dgatf/msrc_arduino/msrc_gui/res/acs758_micro.png

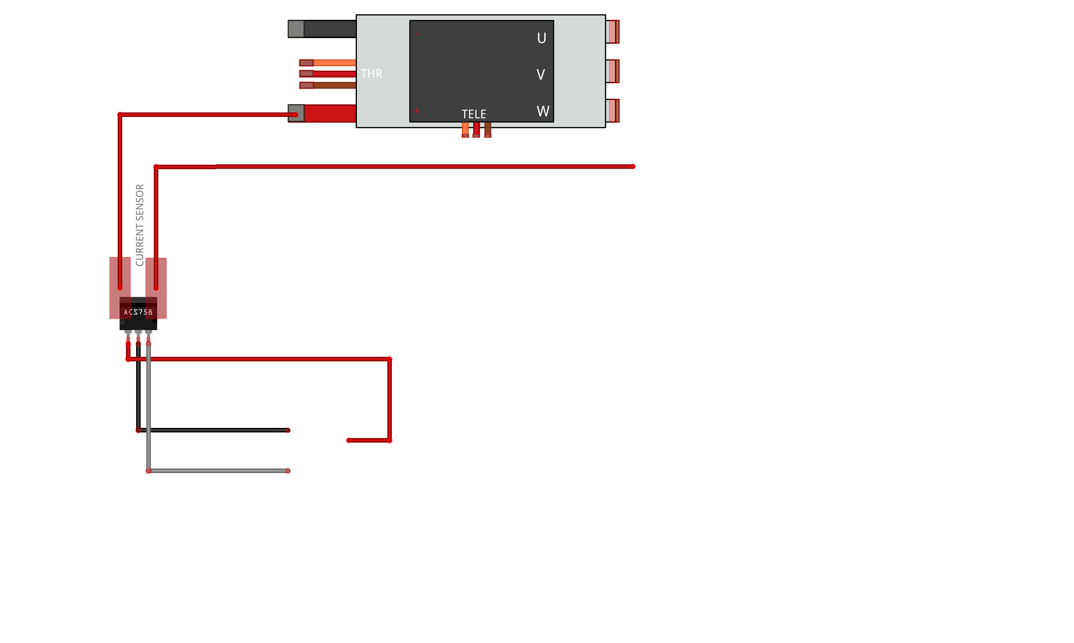
msrc_gui/res/acs758_micro.png
