dgatf/msrc_arduino/msrc_gui/res/acs758_pro_micro.png

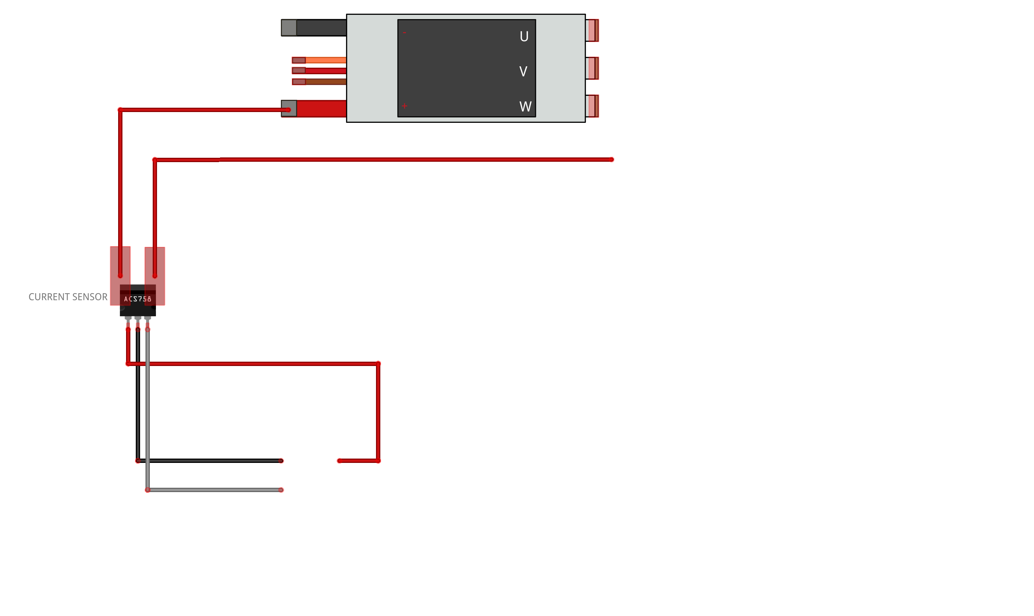
msrc_gui/res/acs758_pro_micro.png
