dgatf/msrc_arduino/msrc_gui/res/batt_esc.png

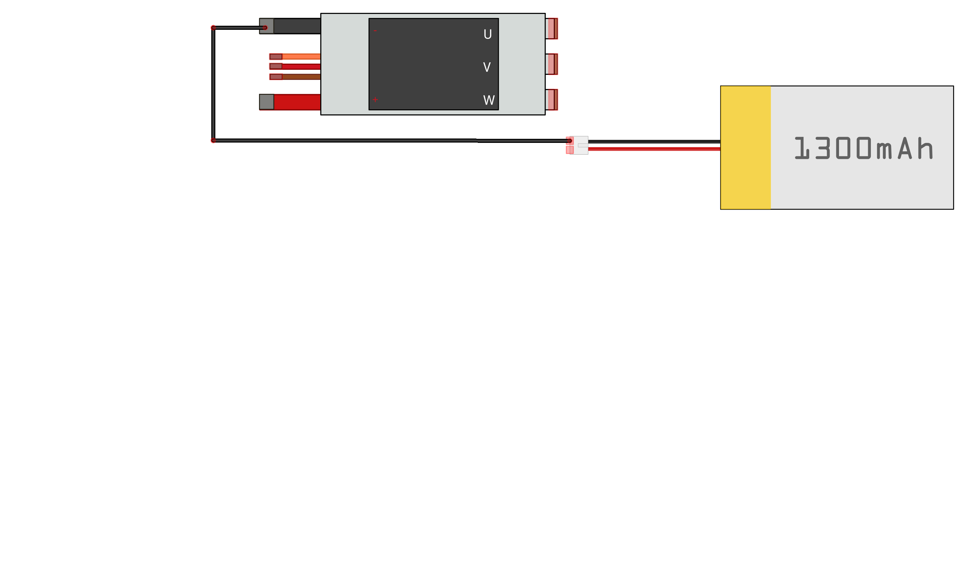
msrc_gui/res/batt_esc.png
