dgatf/msrc_arduino/msrc_gui/res/bmp280_micro.png

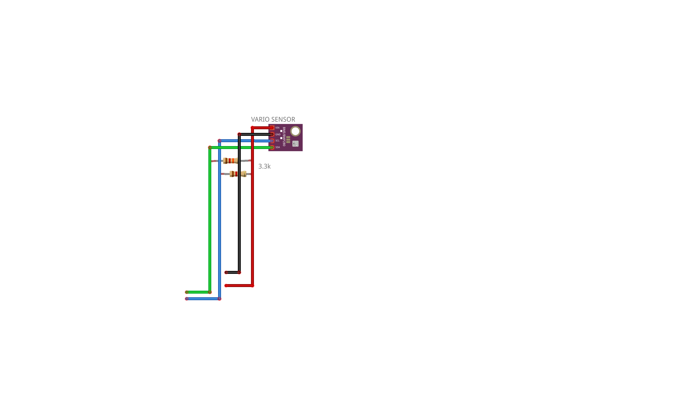
msrc_gui/res/bmp280_micro.png
