dgatf/msrc_arduino/msrc_gui/res/bn220.png

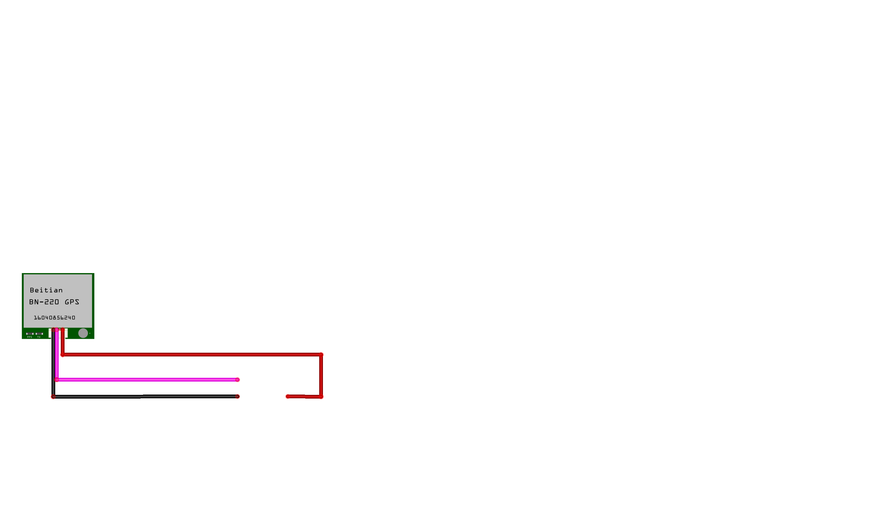
msrc_gui/res/bn220.png
