dgatf/msrc_arduino/msrc_gui/res/bn220_micro.png

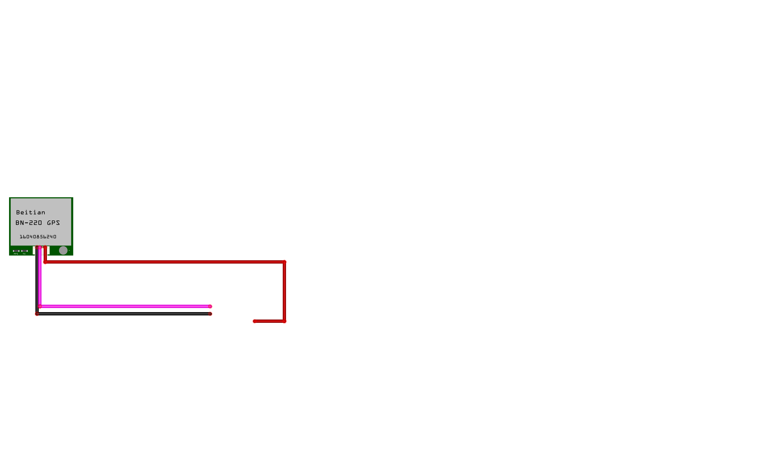
msrc_gui/res/bn220_micro.png
