dgatf/msrc_arduino/msrc_gui/res/esc_castle_micro.png

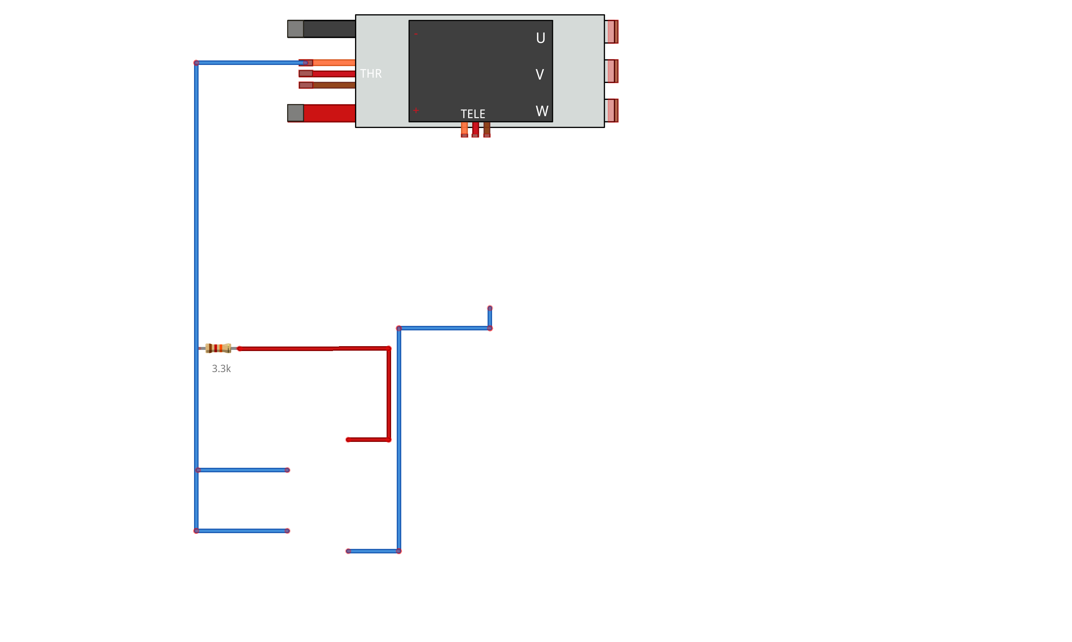
msrc_gui/res/esc_castle_micro.png
