dgatf/msrc_arduino/msrc_gui/res/esc_castle_teensy2.png

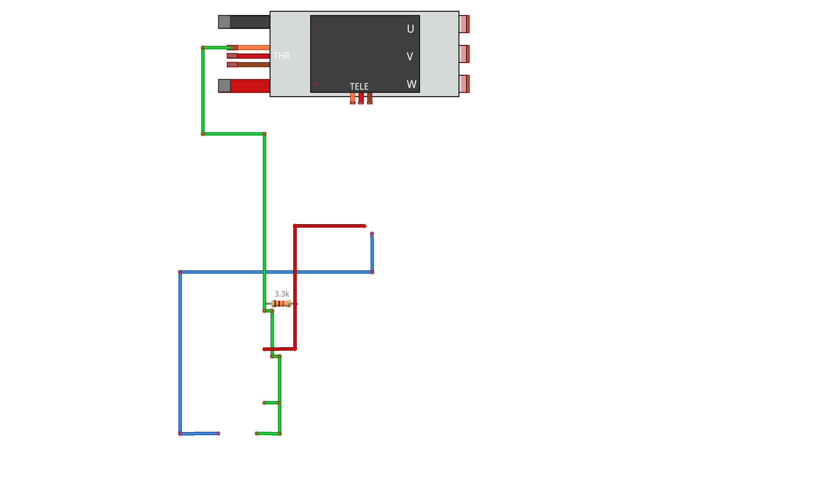
msrc_gui/res/esc_castle_teensy2.png
