dgatf/msrc_arduino/msrc_gui/res/esc_pwm.png

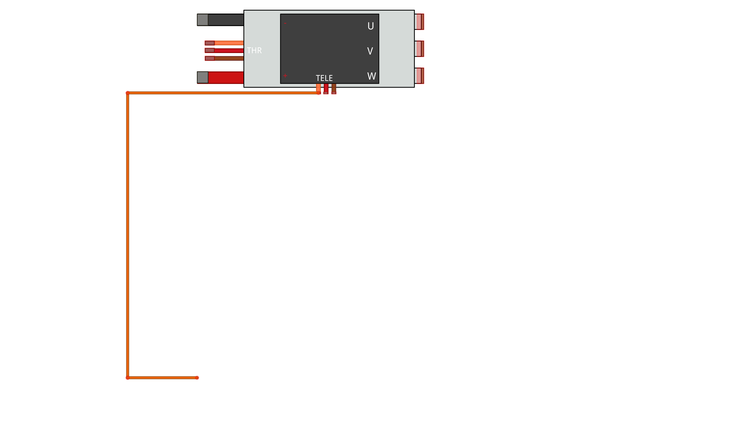
msrc_gui/res/esc_pwm.png
