dgatf/msrc_arduino/msrc_gui/res/esc_pwm_micro.png

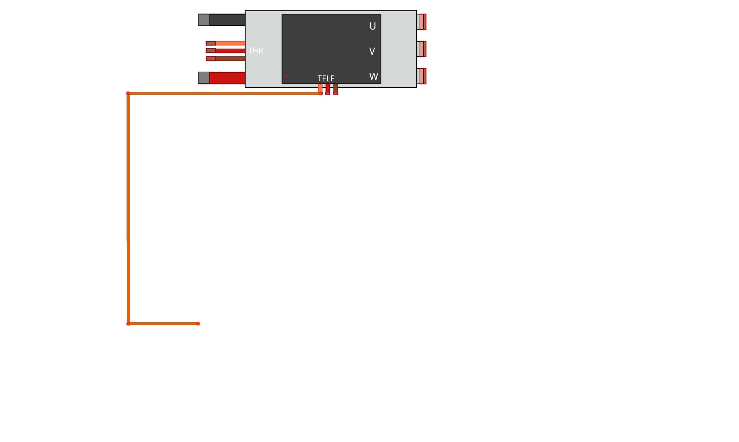
msrc_gui/res/esc_pwm_micro.png
