dgatf/msrc_arduino/msrc_gui/res/micro.png

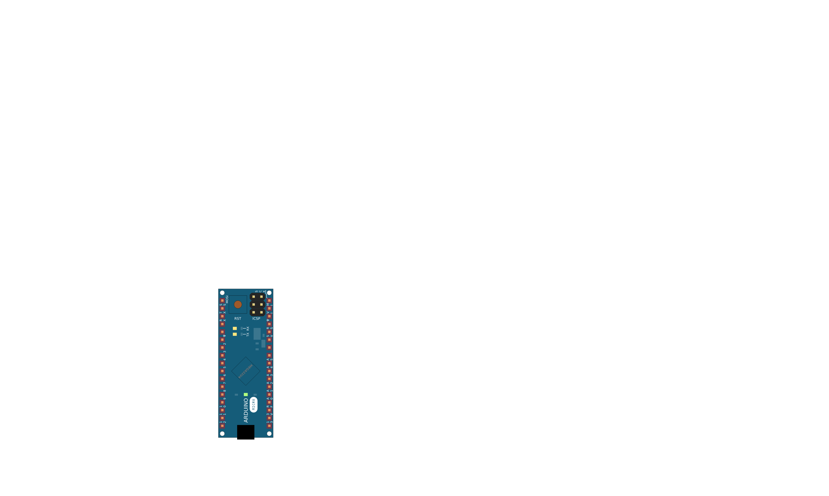
msrc_gui/res/micro.png
