dgatf/msrc_arduino/msrc_gui/res/mpxv7002_micro.png

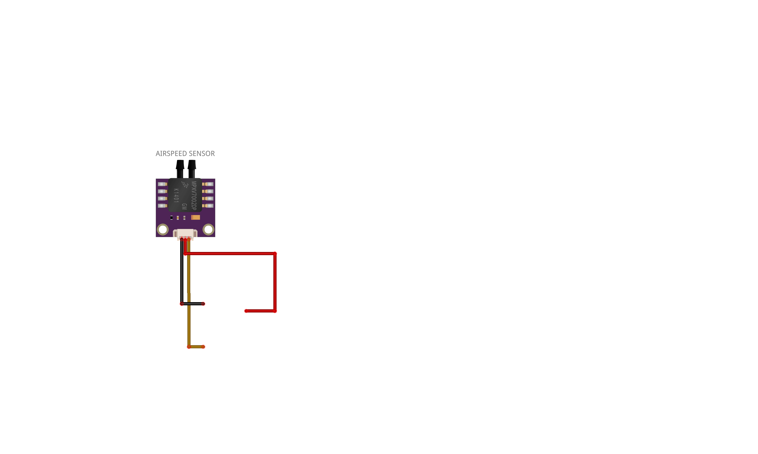
msrc_gui/res/mpxv7002_micro.png
