dgatf/msrc_arduino/msrc_gui/res/ms5611_mini.png

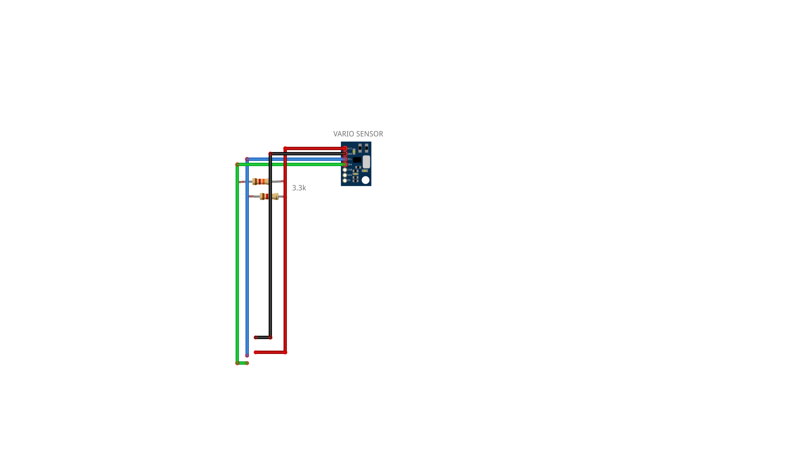
msrc_gui/res/ms5611_mini.png
