dgatf/msrc_arduino/msrc_gui/res/no_acs758.png

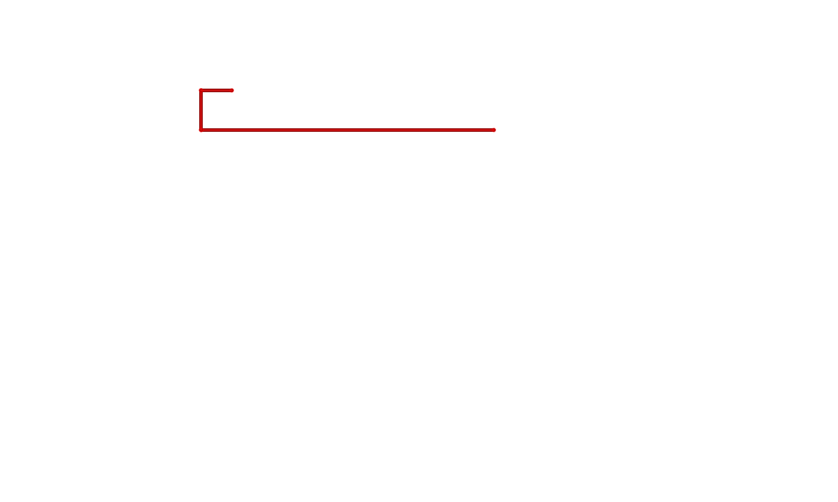
msrc_gui/res/no_acs758.png
