dgatf/msrc_arduino/msrc_gui/res/ntc1.png

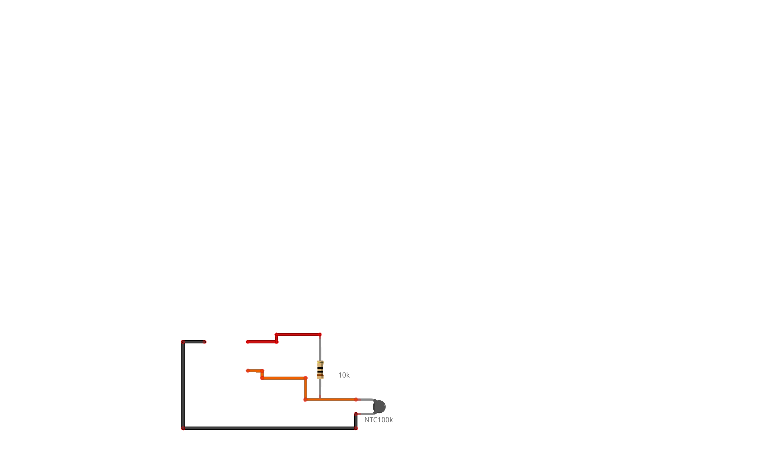
msrc_gui/res/ntc1.png
