dgatf/msrc_arduino/msrc_gui/res/ntc2_teensy3.png

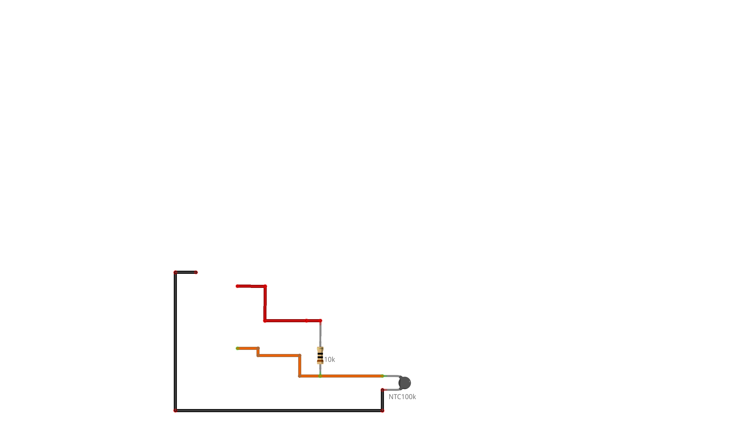
msrc_gui/res/ntc2_teensy3.png
