dgatf/msrc_arduino/msrc_gui/res/receiver_3v_hs.png

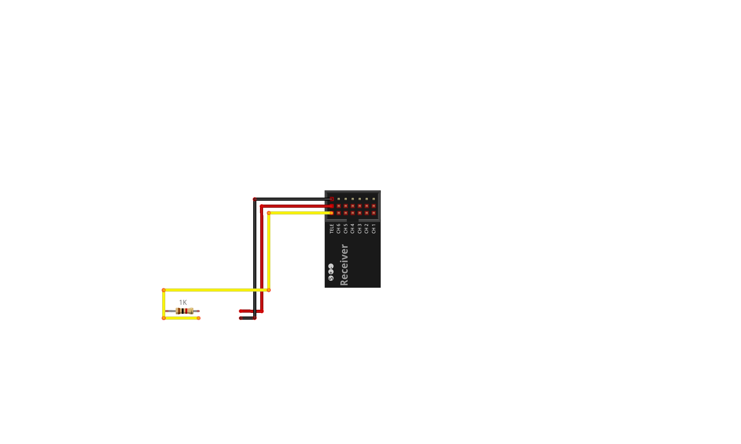
msrc_gui/res/receiver_3v_hs.png
