dgatf/msrc_arduino/msrc_gui/res/receiver_3v_hs_teensy2.png

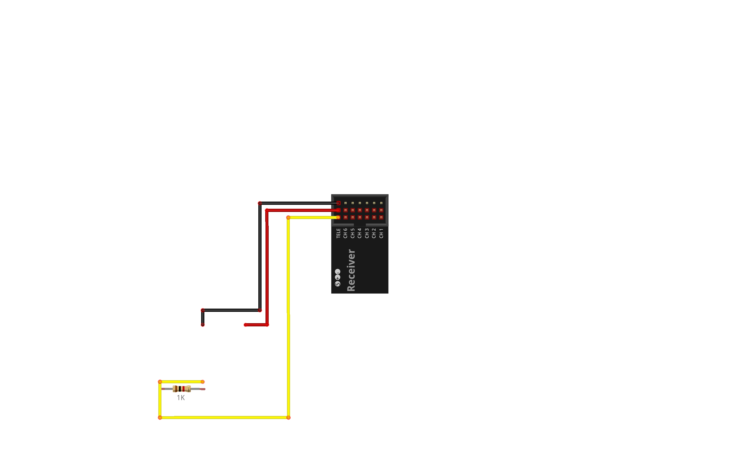
msrc_gui/res/receiver_3v_hs_teensy2.png
