dgatf/msrc_arduino/msrc_gui/res/receiver_3v_i2c_xbus_pro_micro.png

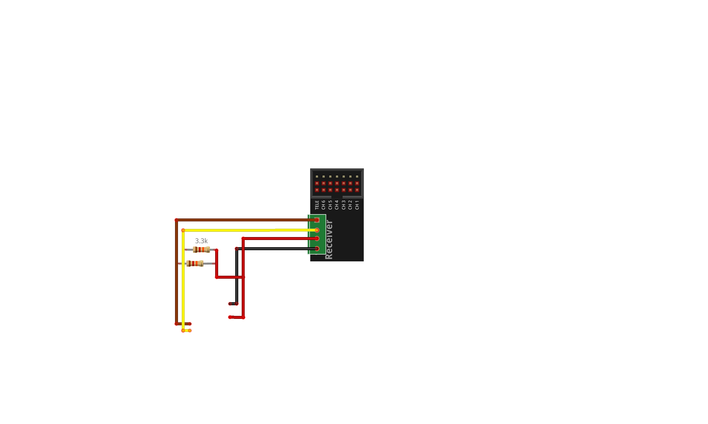
msrc_gui/res/receiver_3v_i2c_xbus_pro_micro.png
