dgatf/msrc_arduino/msrc_gui/res/voltage1.png

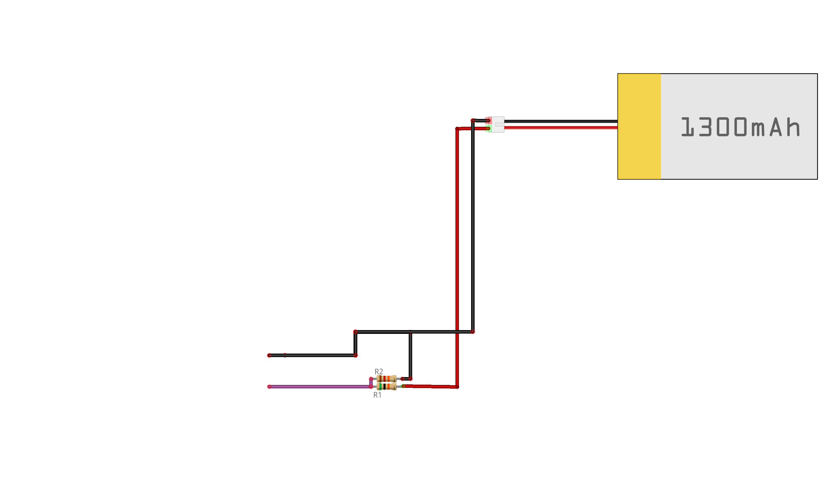
msrc_gui/res/voltage1.png
