dgatf/msrc_arduino/msrc_gui/res/voltage2.png

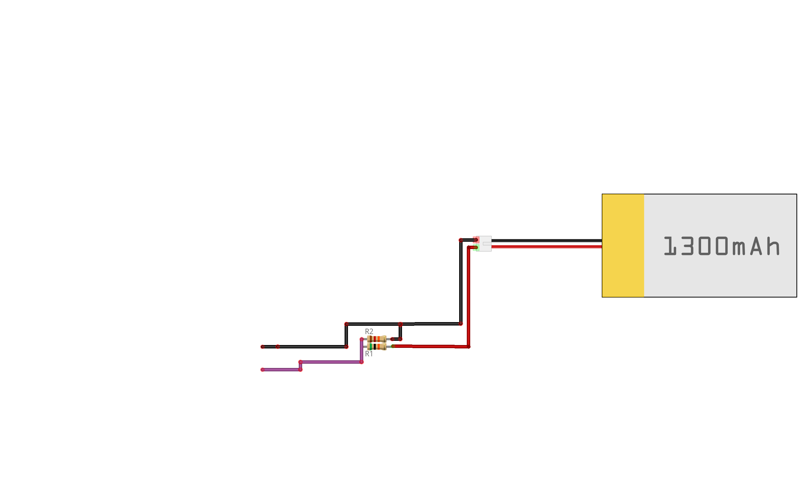
msrc_gui/res/voltage2.png
