dgatf/msrc_arduino/msrc/msrc.cpp

#include "msrc.h"

#if !defined(__AVR_ATmega328P__) && !defined(__AVR_ATmega328PB__) && !defined(ARDUINO_AVR_A_STAR_328PB) && !defined(__AVR_ATmega2560__) && !defined(__AVR_ATmega32U4__) && !defined(__MKL26Z64__) && !defined(__MK20DX128__) && !defined(__MK20DX256__) && !defined(__MK64FX512__) && !defined(__MK66FX1M0__)
#warning "MCU not supported"
#endif

// ISR handlers

#if defined(__AVR_ATmega328P__) && !defined(ARDUINO_AVR_A_STAR_328PB)
void (*TIMER1_CAPT_handlerP)() = NULL;
ISR(TIMER1_CAPT_vect)
{
    if (TIMER1_CAPT_handlerP)
        TIMER1_CAPT_handlerP();
}
void (*TIMER1_COMPB_handlerP)() = NULL;
ISR(TIMER1_COMPB_vect)
{
    if (TIMER1_COMPB_handlerP)
        TIMER1_COMPB_handlerP();
}
void (*TIMER1_OVF_handlerP)() = NULL;
ISR(TIMER1_OVF_vect)
{
    if (TIMER1_OVF_handlerP)
        TIMER1_OVF_handlerP();
}
void (*INT0_handlerP)() = NULL;
ISR(INT0_vect)
{
    if (INT0_handlerP)
        INT0_handlerP();
}
void (*TIMER2_COMPA_handlerP)() = NULL;
ISR(TIMER2_COMPA_vect)
{
    if (TIMER2_COMPA_handlerP)
        TIMER2_COMPA_handlerP();
}
#endif

#if defined(__AVR_ATmega328PB__) || defined(ARDUINO_AVR_A_STAR_328PB)
void (*TIMER1_CAPT_handlerP)() = NULL;
ISR(TIMER1_CAPT_vect)
{
    if (TIMER1_CAPT_handlerP)
        TIMER1_CAPT_handlerP();
}
void (*TIMER1_COMPB_handlerP)() = NULL;
ISR(TIMER1_COMPB_vect)
{
    if (TIMER1_COMPB_handlerP)
        TIMER1_COMPB_handlerP();
}
void (*TIMER1_OVF_handlerP)() = NULL;
ISR(TIMER1_OVF_vect)
{
    if (TIMER1_OVF_handlerP)
        TIMER1_OVF_handlerP();
}
void (*TIMER2_COMPA_handlerP)() = NULL;
ISR(TIMER2_COMPA_vect)
{
    if (TIMER2_COMPA_handlerP)
        TIMER2_COMPA_handlerP();
}
void (*TIMER3_COMPA_handlerP)() = NULL;
ISR(TIMER3_COMPA_vect)
{
    if (TIMER3_COMPA_handlerP)
        TIMER3_COMPA_handlerP();
}
void (*TIMER4_COMPB_handlerP)() = NULL;
ISR(TIMER4_COMPB_vect)
{
    if (TIMER4_COMPB_handlerP)
        TIMER4_COMPB_handlerP();
}
void (*TIMER4_CAPT_handlerP)() = NULL;
ISR(TIMER4_CAPT_vect)
{
    if (TIMER4_CAPT_handlerP)
        TIMER4_CAPT_handlerP();
}
#endif

#if defined(__AVR_ATmega2560__)
void (*TIMER4_CAPT_handlerP)() = NULL;
ISR(TIMER4_CAPT_vect)
{
    if (TIMER4_CAPT_handlerP)
        TIMER4_CAPT_handlerP();
}
void (*TIMER4_COMPB_handlerP)() = NULL;
ISR(TIMER4_COMPB_vect)
{
    if (TIMER4_COMPB_handlerP)
        TIMER4_COMPB_handlerP();
}
void (*TIMER4_OVF_handlerP)() = NULL;
ISR(TIMER4_OVF_vect)
{
    if (TIMER4_OVF_handlerP)
        TIMER4_OVF_handlerP();
}
void (*TIMER5_COMPB_handlerP)() = NULL;
ISR(TIMER5_COMPB_vect)
{
    if (TIMER5_COMPB_handlerP)
        TIMER5_COMPB_handlerP();
}
void (*TIMER5_COMPC_handlerP)() = NULL;
ISR(TIMER5_COMPC_vect)
{
    if (TIMER5_COMPC_handlerP)
        TIMER5_COMPC_handlerP();
}
void (*TIMER5_CAPT_handlerP)() = NULL;
ISR(TIMER5_CAPT_vect)
{
    if (TIMER5_CAPT_handlerP)
        TIMER5_CAPT_handlerP();
}
void (*TIMER2_COMPA_handlerP)() = NULL;
ISR(TIMER2_COMPA_vect)
{
    if (TIMER2_COMPA_handlerP)
        TIMER2_COMPA_handlerP();
}
#endif

#if defined(__AVR_ATmega32U4__)
void (*TIMER1_CAPT_handlerP)() = NULL;
ISR(TIMER1_CAPT_vect)
{
    if (TIMER1_CAPT_handlerP)
        TIMER1_CAPT_handlerP();
}
void (*TIMER1_COMPB_handlerP)() = NULL;
ISR(TIMER1_COMPB_vect)
{
    if (TIMER1_COMPB_handlerP)
        TIMER1_COMPB_handlerP();
}
void (*TIMER1_OVF_handlerP)() = NULL;
ISR(TIMER1_OVF_vect)
{
    if (TIMER1_OVF_handlerP)
        TIMER1_OVF_handlerP();
}
void (*TIMER1_COMPC_handlerP)() = NULL;
ISR(TIMER1_COMPC_vect)
{
    if (TIMER1_COMPC_handlerP)
        TIMER1_COMPC_handlerP();
}
void (*TIMER3_COMPB_handlerP)() = NULL;
ISR(TIMER3_COMPB_vect)
{
    if (TIMER3_COMPB_handlerP)
        TIMER3_COMPB_handlerP();
}
void (*TIMER3_CAPT_handlerP)() = NULL;
ISR(TIMER3_CAPT_vect)
{
    if (TIMER3_CAPT_handlerP)
        TIMER3_CAPT_handlerP();
}
void (*TIMER3_OVF_handlerP)() = NULL;
ISR(TIMER3_OVF_vect)
{
    if (TIMER3_OVF_handlerP)
        TIMER3_OVF_handlerP();
}
void (*TIMER4_COMPB_handlerP)() = NULL;
ISR(TIMER4_COMPB_vect)
{
    if (TIMER4_COMPB_handlerP)
        TIMER4_COMPB_handlerP();
}
#endif

#if defined(__MKL26Z64__) || defined(__MK20DX128__) || defined(__MK20DX256__) || defined(__MK64FX512__) || defined(__MK66FX1M0__) || defined(__IMXRT1062__)
void (*FTM0_IRQ_handlerP)() = NULL;
void ftm0_isr()
{
    if (FTM0_IRQ_handlerP)
        FTM0_IRQ_handlerP();
}
void (*FTM1_IRQ_handlerP)() = NULL;
void ftm1_isr()
{
    if (FTM1_IRQ_handlerP)
        FTM1_IRQ_handlerP();
}
#endif

void setup()
{
#ifdef DEBUG_INIT
    // DEBUG is on Serial. Default baud rate is 115200
    // For boards with 1 UART, baud rate will be changed to ESC or GPS baud rate if enabled
    delay(500);
    DEBUG_INIT;
    DEBUG_PRINT("\nV");
    DEBUG_PRINT(VERSION_MAJOR * 10000 + VERSION_MINOR * 100 + VERSION_PATCH);
    DEBUG_PRINT("\n");
    delay(500);
#endif
#if defined(CONFIG_LUA) && RX_PROTOCOL == RX_SMARTPORT
    ConfigEeprom configEeprom;
    Config config = configEeprom.readConfig();
    if (config.pwmOut)
        pwmOut.enable();
#else
    if (CONFIG_PWMOUT)
        pwmOut.enable();
#endif
    I2C_SENSOR.begin();
    I2C_SENSOR.setTimeout(WIRE_TIMEOUT);
#if defined(ESC_INIT_DELAY)
#if defined(__AVR_ATmega328P__) || defined(__AVR_ATmega328PB__) || defined(ARDUINO_AVR_A_STAR_328PB)
    pinMode(0, OUTPUT);
    digitalWrite(0, LOW);
#endif
#if defined(__AVR_ATmega2560__)
    pinMode(19, OUTPUT);
    digitalWrite(19, LOW);
#endif
#if defined(__AVR_ATmega32U4__)
    pinMode(PB0, OUTPUT);
    digitalWrite(PB0, LOW);
#endif
#if defined(__MKL26Z64__) || defined(__MK20DX128__) || defined(__MK20DX256__) || defined(__MK64FX512__) || defined(__MK66FX1M0__) || defined(__IMXRT1062__)
    pinMode(9, OUTPUT);
    digitalWrite(9, LOW);
#endif
    while (millis() < ESC_INIT_DELAY)
        ;
#endif

#if RX_PROTOCOL == RX_SMARTPORT
    smartport.begin();
#endif
#if RX_PROTOCOL == RX_XBUS
    xbus.begin();
#endif
#if RX_PROTOCOL == RX_SRXL
    srxl.begin();
#endif
#if RX_PROTOCOL == RX_FRSKY
    frsky.begin();
#endif
#if RX_PROTOCOL == RX_IBUS
    ibus.begin();
#endif
#if RX_PROTOCOL == RX_SBUS
    sbus.begin();
#endif
#if RX_PROTOCOL == RX_MULTIPLEX
    multiplex.begin();
#endif
#if RX_PROTOCOL == RX_JETIEX
    jetiEx.begin();
#endif
#if RX_PROTOCOL == RX_HITEC
    hitec.begin();
#endif
}

void loop()
{
#if RX_PROTOCOL == RX_SMARTPORT
    smartport.update();
#endif
#if RX_PROTOCOL == RX_XBUS
    xbus.update();
#endif
#if RX_PROTOCOL == RX_SRXL
    srxl.updateSrxl();
#endif
#if RX_PROTOCOL == RX_FRSKY
    frsky.update();
#endif
#if RX_PROTOCOL == RX_IBUS
    ibus.update();
#endif
#if RX_PROTOCOL == RX_SBUS
    sbus.update();
#endif
#if RX_PROTOCOL == RX_MULTIPLEX
    multiplex.update();
#endif
#if RX_PROTOCOL == RX_JETIEX
    jetiEx.update();
#endif
#if RX_PROTOCOL == RX_HITEC
    hitec.update();
#endif
    pwmOut.update();
}
