dgatf/msrc_arduino/msrc/ibus.cpp

#include "ibus.h"

Ibus::Ibus(AbstractSerial &serial) : serial_(serial)
{
}

Ibus::~Ibus()
{
}

void Ibus::begin()
{
    deviceBufferP = new CircularBuffer<Device>;
    serial_.begin(115200, SERIAL__8N1 | SERIAL__HALF_DUP);
    serial_.setTimeout(IBUS_TIMEOUT);
    pinMode(LED_BUILTIN, OUTPUT);
    setConfig();
}

void Ibus::sendByte(uint8_t c, uint16_t *crcP)
{
    if (crcP != NULL)
    {
        uint16_t crc = *crcP;
        crc += c;
        *crcP = crc;
    }
    serial_.write(c);
#ifdef DEBUG
    DEBUG_PRINT_HEX(c);
    DEBUG_PRINT(" ");
#endif
}

void Ibus::sendData(uint8_t command, uint8_t address)
{
    digitalWrite(LED_BUILTIN, HIGH);

    uint8_t *u8P = NULL;
    uint16_t crc = 0;
    uint16_t type;
    uint8_t lenght = 0;

    switch(sensorIbusP[address]->type())
    {
    case IBUS_TYPE_S16:
    case IBUS_TYPE_U16:
        lenght = 2;
        break;
    case IBUS_TYPE_S32:
        lenght = 4;
        break;
    case IBUS_TYPE_GPS:
        lenght = 14;
        break;
    } 
    switch (command)
    {
    case IBUS_COMMAND_DISCOVER:
        lenght = 0;
        break;
    case IBUS_COMMAND_TYPE:
        type = lenght << 8 | sensorIbusP[address]->dataId();
        u8P = (uint8_t *)&type;
        lenght = 2;
        break;
    case IBUS_COMMAND_MEASURE:
        u8P = sensorIbusP[address]->valueFormatted();
        break;
    }
#ifdef DEBUG
    DEBUG_PRINT("> ");
#endif
    // lenght
    sendByte(4 + lenght, &crc);

    // command & address
    sendByte(command << 4 | address, &crc);

    //value
    for (uint8_t i = 0; i < lenght; i++)
        sendByte(u8P[i], &crc);

    // crc
    crc = 0xFFFF - crc;
    u8P = (uint8_t *)&crc;
    sendByte(u8P[0], NULL);
    sendByte(u8P[1], NULL);

    digitalWrite(LED_BUILTIN, LOW);
#ifdef DEBUG
    DEBUG_PRINTLN();
#endif
}

void Ibus::addSensor(SensorIbus *newSensorIbusP)
{
    for (uint8_t i = 0; i < 16; i++)
    {
        if (sensorIbusP[i] == NULL && sensorMask & 1 << i)
        {
            sensorIbusP[i] = newSensorIbusP;
            return;
        }
    }
}

bool Ibus::checkCrc(uint8_t *data)
{
    uint16_t crc = 0xFFFF;
    uint8_t lenght = data[0];
    for (uint8_t i = 0; i < lenght - 2; i++)
        crc -= data[i];
    if ( crc == (uint16_t)data[lenght - 1] << 8 || data[lenght] )
        return true;
    return false;
}

uint8_t Ibus::read(uint8_t &command, uint8_t &address)
{
    if (serial_.availableTimeout() == IBUS_PACKET_LENGHT)
    {
        uint8_t data[IBUS_PACKET_LENGHT];
        serial_.readBytes(data, IBUS_PACKET_LENGHT);
        if (data[0] == IBUS_PACKET_LENGHT)
        {
#ifdef DEBUG
            DEBUG_PRINT("< ");
            for (uint8_t i = 0; i < data[0]; i++)
            {
                DEBUG_PRINT_HEX(data[i]);
                DEBUG_PRINT(" ");
            }
#endif
            if (checkCrc(data))
            {
#ifdef DEBUG
                DEBUG_PRINT("+");
                DEBUG_PRINTLN();
#endif
                command = data[1] >> 4;
                address = data[1] & 0x0F;
                if (command == IBUS_COMMAND_DISCOVER || command == IBUS_COMMAND_TYPE || IBUS_COMMAND_MEASURE)
                    return IBUS_RECEIVED_POLL;
            }
#ifdef DEBUG
            DEBUG_PRINTLN();
#endif
        }
    }
    return IBUS_RECEIVED_NONE;
}

void Ibus::update()
{
#if defined(SIM_RX)
    static uint8_t command = IBUS_COMMAND_DISCOVER;
    static uint8_t address = 0;
    static uint16_t ts = 0;
    uint8_t packetType = IBUS_RECEIVED_NONE;
    if ((uint16_t)(millis() - ts) > 100)
    {
        packetType = IBUS_RECEIVED_POLL;
        address++;
        ts = millis();
        if (address == 16)
        {
            address = 0;
            if (command < IBUS_COMMAND_MEASURE)
                command++;
        }
    }
#else
    uint8_t command;
    uint8_t address;
    uint8_t packetType = read(command, address);
#endif
    if (packetType == IBUS_RECEIVED_POLL && sensorIbusP[address])
        sendData(command, address);

    // update device
    if (deviceBufferP->current())
    {
        deviceBufferP->current()->update();
        deviceBufferP->next();
    }
}

void Ibus::setConfig()
{
     /*
     - Sensor at address 0x00 is reserved
     - Sensor at address 0x01 is recerved in some receivers types. But the poll at address 0x01, if present, has to be answered (so there is a dummy sensor at address 0x01), otherwise the sensor poll scan is stopped from receiver
     - TODO: dinamically set the sensor address to allocate an additional sensor in receivers with only one sensor masked
    */
    SensorIbus *sensorIbusP;
    sensorIbusP = new SensorIbus(AFHDS2A_ID_END, 0, NULL);
    addSensor(sensorIbusP);
    if (CONFIG_ESC_PROTOCOL == PROTOCOL_PWM)
    {
        SensorIbus *sensorIbusP;
        EscPWM *esc;
        esc = new EscPWM(ALPHA(CONFIG_AVERAGING_ELEMENTS_RPM));
        esc->begin();
        deviceBufferP->add(esc);
        sensorIbusP = new SensorIbus(AFHDS2A_ID_MOT, IBUS_TYPE_U16, esc->rpmP());
        addSensor(sensorIbusP);
    }
    if (CONFIG_ESC_PROTOCOL == PROTOCOL_HW_V3)
    {
        SensorIbus *sensorIbusP;
        EscHW3 *esc;
        esc = new EscHW3(ESC_SERIAL, ALPHA(CONFIG_AVERAGING_ELEMENTS_RPM));
        esc->begin();
        deviceBufferP->add(esc);
        sensorIbusP = new SensorIbus(AFHDS2A_ID_MOT, IBUS_TYPE_U16, esc->rpmP());
        addSensor(sensorIbusP);
    }
    if (CONFIG_ESC_PROTOCOL == PROTOCOL_HW_V4)
    {
        SensorIbus *sensorIbusP;
        EscHW4 *esc;
        esc = new EscHW4(ESC_SERIAL, ALPHA(CONFIG_AVERAGING_ELEMENTS_RPM), ALPHA(CONFIG_AVERAGING_ELEMENTS_VOLT), ALPHA(CONFIG_AVERAGING_ELEMENTS_CURR), ALPHA(CONFIG_AVERAGING_ELEMENTS_TEMP), 0);
        esc->begin();
        deviceBufferP->add(esc);
        PwmOut pwmOut;
        pwmOut.setRpmP(esc->rpmP());
        sensorIbusP = new SensorIbus(AFHDS2A_ID_MOT, IBUS_TYPE_U16, esc->rpmP());
        addSensor(sensorIbusP);
        sensorIbusP = new SensorIbus(AFHDS2A_ID_EXTV, IBUS_TYPE_U16, esc->voltageP());
        addSensor(sensorIbusP);
        sensorIbusP = new SensorIbus(AFHDS2A_ID_BAT_CURR, IBUS_TYPE_U16, esc->currentP());
        addSensor(sensorIbusP);
        sensorIbusP = new SensorIbus(AFHDS2A_ID_TEMPERATURE, IBUS_TYPE_U16, esc->tempFetP());
        addSensor(sensorIbusP);
        sensorIbusP = new SensorIbus(AFHDS2A_ID_TEMPERATURE, IBUS_TYPE_U16, esc->tempBecP());
        addSensor(sensorIbusP);
        sensorIbusP = new SensorIbus(AFHDS2A_ID_CELL_VOLTAGE, IBUS_TYPE_U16, esc->cellVoltageP());
        addSensor(sensorIbusP);
        sensorIbusP = new SensorIbus(AFHDS2A_ID_FUEL, IBUS_TYPE_U16, esc->consumptionP());
        addSensor(sensorIbusP);
    }
    if (CONFIG_ESC_PROTOCOL == PROTOCOL_CASTLE)
    {
        SensorIbus *sensorIbusP;
        EscCastle *esc;
        esc = new EscCastle(ALPHA(CONFIG_AVERAGING_ELEMENTS_RPM), ALPHA(CONFIG_AVERAGING_ELEMENTS_VOLT), ALPHA(CONFIG_AVERAGING_ELEMENTS_CURR), ALPHA(CONFIG_AVERAGING_ELEMENTS_TEMP));
        esc->begin();
        deviceBufferP->add(esc);
        sensorIbusP = new SensorIbus(AFHDS2A_ID_MOT, IBUS_TYPE_U16, esc->rpmP());
        addSensor(sensorIbusP);
        sensorIbusP = new SensorIbus(AFHDS2A_ID_EXTV, IBUS_TYPE_U16, esc->voltageP());
        addSensor(sensorIbusP);
        sensorIbusP = new SensorIbus(AFHDS2A_ID_BAT_CURR, IBUS_TYPE_U16, esc->currentP());
        addSensor(sensorIbusP);
        sensorIbusP = new SensorIbus(AFHDS2A_ID_EXTV, IBUS_TYPE_U16, esc->becVoltageP());
        addSensor(sensorIbusP);
        sensorIbusP = new SensorIbus(AFHDS2A_ID_BAT_CURR, IBUS_TYPE_U16, esc->becCurrentP());
        addSensor(sensorIbusP);
        sensorIbusP = new SensorIbus(AFHDS2A_ID_EXTV, IBUS_TYPE_U16, esc->rippleVoltageP());
        addSensor(sensorIbusP);
        sensorIbusP = new SensorIbus(AFHDS2A_ID_TEMPERATURE, IBUS_TYPE_U16, esc->temperatureP());
        addSensor(sensorIbusP);
        sensorIbusP = new SensorIbus(AFHDS2A_ID_CELL_VOLTAGE, IBUS_TYPE_U16, esc->cellVoltageP());
        addSensor(sensorIbusP);
        sensorIbusP = new SensorIbus(AFHDS2A_ID_FUEL, IBUS_TYPE_U16, esc->consumptionP());
        addSensor(sensorIbusP);
    }
    if (CONFIG_ESC_PROTOCOL == PROTOCOL_KONTRONIK)
    {
        SensorIbus *sensorIbusP;
        EscKontronik *esc;
        esc = new EscKontronik(ESC_SERIAL, ALPHA(CONFIG_AVERAGING_ELEMENTS_RPM), ALPHA(CONFIG_AVERAGING_ELEMENTS_VOLT), ALPHA(CONFIG_AVERAGING_ELEMENTS_CURR), ALPHA(CONFIG_AVERAGING_ELEMENTS_TEMP));
        esc->begin();
        deviceBufferP->add(esc);
        sensorIbusP = new SensorIbus(AFHDS2A_ID_MOT, IBUS_TYPE_U16, esc->rpmP());
        addSensor(sensorIbusP);
        sensorIbusP = new SensorIbus(AFHDS2A_ID_EXTV, IBUS_TYPE_U16, esc->voltageP());
        addSensor(sensorIbusP);
        sensorIbusP = new SensorIbus(AFHDS2A_ID_BAT_CURR, IBUS_TYPE_U16, esc->currentP());
        addSensor(sensorIbusP);
        sensorIbusP = new SensorIbus(AFHDS2A_ID_EXTV, IBUS_TYPE_U16, esc->becVoltageP());
        addSensor(sensorIbusP);
        sensorIbusP = new SensorIbus(AFHDS2A_ID_BAT_CURR, IBUS_TYPE_U16, esc->becCurrentP());
        addSensor(sensorIbusP);
        sensorIbusP = new SensorIbus(AFHDS2A_ID_TEMPERATURE, IBUS_TYPE_U16, esc->tempFetP());
        addSensor(sensorIbusP);
        sensorIbusP = new SensorIbus(AFHDS2A_ID_TEMPERATURE, IBUS_TYPE_U16, esc->tempBecP());
        addSensor(sensorIbusP);
        sensorIbusP = new SensorIbus(AFHDS2A_ID_CELL_VOLTAGE, IBUS_TYPE_U16, esc->cellVoltageP());
        addSensor(sensorIbusP);
        sensorIbusP = new SensorIbus(AFHDS2A_ID_FUEL, IBUS_TYPE_U16, esc->consumptionP());
        addSensor(sensorIbusP);
    }
    if (CONFIG_ESC_PROTOCOL == PROTOCOL_APD_F)
    {
        SensorIbus *sensorIbusP;
        EscApdF *esc;
        esc = new EscApdF(ESC_SERIAL, ALPHA(CONFIG_AVERAGING_ELEMENTS_RPM), ALPHA(CONFIG_AVERAGING_ELEMENTS_VOLT), ALPHA(CONFIG_AVERAGING_ELEMENTS_CURR), ALPHA(CONFIG_AVERAGING_ELEMENTS_TEMP));
        esc->begin();
        deviceBufferP->add(esc);
        //PwmOut pwmOut;
        //pwmOut.setRpmP(esc->rpmP());
        sensorIbusP = new SensorIbus(AFHDS2A_ID_MOT, IBUS_TYPE_U16, esc->rpmP());
        addSensor(sensorIbusP);
        sensorIbusP = new SensorIbus(AFHDS2A_ID_EXTV, IBUS_TYPE_U16, esc->voltageP());
        addSensor(sensorIbusP);
        sensorIbusP = new SensorIbus(AFHDS2A_ID_BAT_CURR, IBUS_TYPE_U16, esc->currentP());
        addSensor(sensorIbusP);
        sensorIbusP = new SensorIbus(AFHDS2A_ID_TEMPERATURE, IBUS_TYPE_U16, esc->tempP());
        addSensor(sensorIbusP);
        sensorIbusP = new SensorIbus(AFHDS2A_ID_FUEL, IBUS_TYPE_U16, esc->consumptionP());
        addSensor(sensorIbusP);
        sensorIbusP = new SensorIbus(AFHDS2A_ID_CELL_VOLTAGE, IBUS_TYPE_U16, esc->cellVoltageP());
        addSensor(sensorIbusP);
    }
    if (CONFIG_ESC_PROTOCOL == PROTOCOL_APD_HV)
    {
        SensorIbus *sensorIbusP;
        EscApdHV *esc;
        esc = new EscApdHV(ESC_SERIAL, ALPHA(CONFIG_AVERAGING_ELEMENTS_RPM), ALPHA(CONFIG_AVERAGING_ELEMENTS_VOLT), ALPHA(CONFIG_AVERAGING_ELEMENTS_CURR), ALPHA(CONFIG_AVERAGING_ELEMENTS_TEMP));
        esc->begin();
        deviceBufferP->add(esc);
        sensorIbusP = new SensorIbus(AFHDS2A_ID_MOT, IBUS_TYPE_U16, esc->rpmP());
        addSensor(sensorIbusP);
        sensorIbusP = new SensorIbus(AFHDS2A_ID_EXTV, IBUS_TYPE_U16, esc->voltageP());
        addSensor(sensorIbusP);
        sensorIbusP = new SensorIbus(AFHDS2A_ID_BAT_CURR, IBUS_TYPE_U16, esc->currentP());
        addSensor(sensorIbusP);
        sensorIbusP = new SensorIbus(AFHDS2A_ID_TEMPERATURE, IBUS_TYPE_U16, esc->tempP());
        addSensor(sensorIbusP);
        sensorIbusP = new SensorIbus(AFHDS2A_ID_FUEL, IBUS_TYPE_U16, esc->consumptionP());
        addSensor(sensorIbusP);
        sensorIbusP = new SensorIbus(AFHDS2A_ID_CELL_VOLTAGE, IBUS_TYPE_U16, esc->cellVoltageP());
        addSensor(sensorIbusP);
    }
    if (CONFIG_GPS)
    {
        SensorIbus *sensorIbusP;
        Bn220 *gps;
        gps = new Bn220(GPS_SERIAL, GPS_BAUD_RATE);
        gps->begin();
        deviceBufferP->add(gps);
        sensorIbusP = new SensorIbus(AFHDS2A_ID_GPS_STATUS, IBUS_TYPE_U16, gps->satP());
        addSensor(sensorIbusP);
        sensorIbusP = new SensorIbus(AFHDS2A_ID_GPS_LAT, IBUS_TYPE_S32, gps->latP());
        addSensor(sensorIbusP);
        sensorIbusP = new SensorIbus(AFHDS2A_ID_GPS_LON, IBUS_TYPE_S32, gps->lonP());
        addSensor(sensorIbusP);
        sensorIbusP = new SensorIbus(AFHDS2A_ID_GPS_ALT, IBUS_TYPE_S32, gps->altP());
        addSensor(sensorIbusP);
        sensorIbusP = new SensorIbus(AFHDS2A_ID_SPE, IBUS_TYPE_U16, gps->spdP());
        addSensor(sensorIbusP);
        sensorIbusP = new SensorIbus(AFHDS2A_ID_COG, IBUS_TYPE_U16, gps->cogP());
        addSensor(sensorIbusP);
        sensorIbusP = new SensorIbus(AFHDS2A_ID_CLIMB_RATE, IBUS_TYPE_S16, gps->varioP());
        addSensor(sensorIbusP);
        sensorIbusP = new SensorIbus(AFHDS2A_ID_GPS_DIST, IBUS_TYPE_U16, gps->distP());
        addSensor(sensorIbusP);
#ifdef IBUS_GPS_ALTERNATIVE_LAT_LON
        sensorIbusP = new SensorIbus(AFHDS2A_ID_S84, IBUS_TYPE_S32, gps->latP());
        addSensor(sensorIbusP);
        sensorIbusP = new SensorIbus(AFHDS2A_ID_S85, IBUS_TYPE_S32, gps->lonP());
        addSensor(sensorIbusP);
#endif
    }
    if (CONFIG_AIRSPEED)
    {
        SensorIbus *sensorIbusP;
        Pressure *pressure;
        pressure = new Pressure(PIN_PRESSURE, ALPHA(CONFIG_AVERAGING_ELEMENTS_VOLT));
        deviceBufferP->add(pressure);
        sensorIbusP = new SensorIbus(AFHDS2A_ID_SPE, IBUS_TYPE_S16, pressure->valueP());
        addSensor(sensorIbusP);
    }
    if (CONFIG_VOLTAGE1)
    {
        SensorIbus *sensorIbusP;
        Voltage *voltage;
        voltage = new Voltage(PIN_VOLTAGE1, ALPHA(CONFIG_AVERAGING_ELEMENTS_VOLT), VOLTAGE1_MULTIPLIER);
        deviceBufferP->add(voltage);
        sensorIbusP = new SensorIbus(AFHDS2A_ID_EXTV, IBUS_TYPE_U16, voltage->valueP());
        addSensor(sensorIbusP);
    }
    if (CONFIG_VOLTAGE2)
    {
        SensorIbus *sensorIbusP;
        Voltage *voltage;
        voltage = new Voltage(PIN_VOLTAGE2, ALPHA(CONFIG_AVERAGING_ELEMENTS_VOLT), VOLTAGE2_MULTIPLIER);
        deviceBufferP->add(voltage);
        sensorIbusP = new SensorIbus(AFHDS2A_ID_EXTV, IBUS_TYPE_U16, voltage->valueP());
        addSensor(sensorIbusP);
    }
    if (CONFIG_CURRENT)
    {
        SensorIbus *sensorIbusP;
        Current *current;
        current = new Current(PIN_CURRENT, ALPHA(CONFIG_AVERAGING_ELEMENTS_CURR), CURRENT_MULTIPLIER, CURRENT_OFFSET, CURRENT_AUTO_OFFSET);
        deviceBufferP->add(current);
        sensorIbusP = new SensorIbus(AFHDS2A_ID_BAT_CURR, IBUS_TYPE_U16, current->valueP());
        addSensor(sensorIbusP);
        sensorIbusP = new SensorIbus(AFHDS2A_ID_FUEL, IBUS_TYPE_U16, current->consumptionP());
        addSensor(sensorIbusP);
    }
    if (CONFIG_NTC1)
    {
        SensorIbus *sensorIbusP;
        Ntc *ntc;
        ntc = new Ntc(PIN_NTC1, ALPHA(CONFIG_AVERAGING_ELEMENTS_TEMP));
        deviceBufferP->add(ntc);
        sensorIbusP = new SensorIbus(AFHDS2A_ID_TEMPERATURE, IBUS_TYPE_U16, ntc->valueP());
        addSensor(sensorIbusP);
    }
    if (CONFIG_NTC2)
    {
        SensorIbus *sensorIbusP;
        Ntc *ntc;
        ntc = new Ntc(PIN_NTC2, ALPHA(CONFIG_AVERAGING_ELEMENTS_TEMP));
        deviceBufferP->add(ntc);
        sensorIbusP = new SensorIbus(AFHDS2A_ID_TEMPERATURE, IBUS_TYPE_U16, ntc->valueP());
        addSensor(sensorIbusP);
    }
    if (CONFIG_I2C1_TYPE == I2C_BMP280)
    {
        SensorIbus *sensorIbusP;
        Bmp280 *bmp;
        bmp = new Bmp280(CONFIG_I2C1_ADDRESS, ALPHA(CONFIG_AVERAGING_ELEMENTS_VARIO));
        bmp->begin();
        deviceBufferP->add(bmp);
        sensorIbusP = new SensorIbus(AFHDS2A_ID_TEMPERATURE, IBUS_TYPE_U16, bmp->temperatureP());
        addSensor(sensorIbusP);
        sensorIbusP = new SensorIbus(AFHDS2A_ID_ALT, IBUS_TYPE_S32, bmp->altitudeP());
        addSensor(sensorIbusP);
        sensorIbusP = new SensorIbus(AFHDS2A_ID_CLIMB_RATE, IBUS_TYPE_S16, bmp->varioP());
        addSensor(sensorIbusP);
    }
    if (CONFIG_I2C1_TYPE == I2C_MS5611)
    {
        SensorIbus *sensorIbusP;
        MS5611 *bmp;
        bmp = new MS5611(CONFIG_I2C1_ADDRESS, ALPHA(CONFIG_AVERAGING_ELEMENTS_VARIO));
        bmp->begin();
        deviceBufferP->add(bmp);
        sensorIbusP = new SensorIbus(AFHDS2A_ID_TEMPERATURE, IBUS_TYPE_U16, bmp->temperatureP());
        addSensor(sensorIbusP);
        sensorIbusP = new SensorIbus(AFHDS2A_ID_ALT, IBUS_TYPE_S32, bmp->altitudeP());
        addSensor(sensorIbusP);
        sensorIbusP = new SensorIbus(AFHDS2A_ID_CLIMB_RATE, IBUS_TYPE_S16, bmp->varioP());
        addSensor(sensorIbusP);
    }
}
