dgatf/msrc_arduino/msrc/sbus.h

#ifndef SBUS_H
#define SBUS_H

#include <Arduino.h>
#include "softserial.h"
#include "hardserial.h"
#include "sensor.h"
#include "constants.h"

#include "escHW3.h"
#include "escHW4.h"
#include "escPWM.h"
#include "escCastle.h"
#include "escKontronik.h"
#include "escApdF.h"
#include "escApdHV.h"
#include "voltage.h"
#include "current.h"
#include "ntc.h"
#include "pressure.h"
#include "bmp280.h"
#include "ms5611.h"
#include "bn220.h"
#include "configeeprom.h"
#include "pwmout.h"

#define SBUS_SERIAL_TIMEOUT 1500
#define SBUS_PACKET_LENGHT 25

#define SBUS_WAIT 0
#define SBUS_SEND 1

#define SBUS_SLOT_0_DELAY 2000
#define SBUS_INTER_SLOT_DELAY 700

#define SBUS_SLOT_TEMP1 1
#define SBUS_SLOT_RPM 2
#define SBUS_SLOT_VARIO_SPEED 3
#define SBUS_SLOT_VARIO_ALT 4
#define SBUS_SLOT_VARIO_RESSURE 5
#define SBUS_SLOT_VOLT_V1 6
#define SBUS_SLOT_VOLT_V2 7

#define SBUS_SLOT_GPS_SPD 8
#define SBUS_SLOT_GPS_ALT 9
#define SBUS_SLOT_GPS_TIME 10
#define SBUS_SLOT_GPS_VARIO 11
#define SBUS_SLOT_GPS_LAT1 12
#define SBUS_SLOT_GPS_LAT2 13
#define SBUS_SLOT_GPS_LON1 14
#define SBUS_SLOT_GPS_LON2 15

#define SBUS_SLOT_AIR_SPEED 16

#define SBUS_SLOT_POWER_CURR1 24
#define SBUS_SLOT_POWER_VOLT1 25
#define SBUS_SLOT_POWER_CONS1 26
#define SBUS_SLOT_POWER_CURR2 27
#define SBUS_SLOT_POWER_VOLT2 28
#define SBUS_SLOT_POWER_CONS2 29
#define SBUS_SLOT_TEMP2 30

/*

Slots sensor mapping for Futaba transmitters:

| Slot   | Sensor                               |
| :----: | :----------------------------------: |
|0       | RX voltage (reserved)                |
|1       | Temperature 1 (SBS-01T/TE)           |
|2       | RPM (type magnet)(SBS-01RB/RM/RO)    |
|3-4     | Vario-F1672                          |
|6-7     | Voltage (SBS-01V)                    |
|8-15    | GPS-F1675                            |
|16      | Air speed (SBS-01TAS)                |
|17-23   | Unused                               |
|24-26   | Current 1 (SBS-01C)                  |
|27-29(+)| Current 2 (SBS-01C)                  |
|30(+)   | Temperature 2 (SBS-01T/TE)           |
|31      | Unused                               |

(+) Non default slots

*/

#if defined(__AVR_ATmega328P__) ||  defined(__AVR_ATmega328PB__) || defined(ARDUINO_AVR_A_STAR_328PB) || defined(__AVR_ATmega2560__)
extern void (*TIMER2_COMPA_handlerP)();
#endif

#if defined(__AVR_ATmega32U4__)
extern void (*TIMER4_COMPB_handlerP)();
#endif

#if defined(__MKL26Z64__) || defined(__MK20DX128__) || defined(__MK20DX256__) || defined(__MK64FX512__) || defined(__MK66FX1M0__)
extern void (*FTM0_IRQ_handlerP)();
#endif

class Sbus
{
private:
    static volatile uint8_t slotCont;
    AbstractSerial &serial_;
    static uint8_t telemetryPacket;
    static SensorSbus *sensorSbusP[32];
    CircularBuffer<Device> *deviceBufferP;
    static const uint8_t slotId[32];
#if defined(__AVR_ATmega328P__) || defined(__AVR_ATmega328PB__) || defined(ARDUINO_AVR_A_STAR_328PB) || defined(__AVR_ATmega2560__) || defined(__AVR_ATmega32U4__)
    static void TIMER_COMP_handler();
#endif
#if defined(__MKL26Z64__) || defined(__MK20DX128__) || defined(__MK20DX256__) || defined(__MK64FX512__) || defined(__MK66FX1M0__)
    static void FTM0_IRQ_handler();
#endif
    static void sendSlot(uint8_t number);
    void sendPacket();
    static uint32_t ts2;

public:
    Sbus(AbstractSerial &serial);
    ~Sbus();
    void begin();
    void addSensor(uint8_t slot, SensorSbus *newSensorSbusP);
    void update();
    void setConfig();
};

#endif
