dgatf/msrc_arduino/msrc/pressure.h

#ifndef PRESSURE_H
#define PRESSURE_H

#define AIR_DENS 1.204  // 20ºC, 1atm
#define KNOT_TO_MS 1.94384
// Transfer function: P(Pa) = 1000 * (Vo/(SLOPE*VCC) - voltageOffset)
// MPXV7002
#define TRANSFER_SLOPE 0.2
#define TRANSFER_VCC 5

#include <Arduino.h>
#include "voltage.h"

class Pressure : public Voltage
{
private:
    float voltageOffset = 0;
public:
    Pressure(uint8_t pin, uint8_t alpha);
    void update();
};

#endif
