dgatf/msrc_arduino/(commit log)

2019-05-23 Updated voltage divider resistor values
2019-05-23 Uptate circuit with Castle
2019-05-25 Improved PWM IN and PWM OUT accuracy
2019-05-26 Added debug for voltage analog
2019-05-27 Fixed voltage analog
2019-05-27 Changed volt analog to A3 sensor
2019-05-27 Changed pin smartport rx to 10, to avoid conflic with pwm in
2019-05-29 Smartport optimization and updated debug mode for esc
2019-06-05 Fixed wrong RPM value from PWM IN
2019-06-07 Added support for NTC thermistor
2019-06-07 Added support for various analog sensors
2019-06-10 Analog current sensor bug fix. Garbage ntc readings when not connected changed to 0
2019-06-14 Increased rpm trigger for PWM in
2019-06-17 PWM out update
2019-06-17 PWM out updated
2019-06-27 Added consumption sensor
2019-07-10 Added pwm out average. Added refresh and queue to lua config
2019-07-13 Pwm in bug fixed
2019-07-14 Fixed HWV3 rpm to 0 when motor stops
2019-07-15 Pwm in trigger reduced. Optimized interrupt function
2019-07-16 Pwm in false rpms readings when motor is stopped improved
2019-07-16 Pwm in filter improved
2019-07-26 Added esc current sensor
2019-07-26 Esc current added
2019-12-24 Voltage multiplier (V4/V5) adjusted
2019-12-24 Fixed esc current bug. Added cell average
2020-02-02 Applied correct transformation for esc voltage and temperature (HW V4/V5)
2020-02-02 Fixed transformation for esc voltage and temp
2020-02-06 Fix current transform (HW V4/V5)
2020-02-06 Add esc protocol NONE
2020-02-28 Fix sensor null update
    [smartport.cpp, smartport.h]
2020-03-16 Add index filter
2020-03-16 Add delete sensors to init
2020-03-16 Fix pointers creation/deletion bug
    [smartport.cpp]
2020-03-22 Sensor config smartport protocol compliance
2020-03-30 Discard packets with frameid 0x00 and 0x10
2020-03-30 Change R3 resistor to 3.3k
2020-05-01 Split classes device and sensor
2020-05-01 Add isr handlers. Change esc output to pwm
2020-05-01 Change esc output to pwm
2020-05-04 Fix broken config protocol
    [msrc.cpp]
2020-05-08 Add pull up resistor
2020-05-08 Add pullup resistor
2020-05-10 Fix index and cellcount bugs
    [escCastle.cpp]
2020-05-10 Update pullup resistor
2020-05-14 Add lost connection failsafe
    [escCastle.cpp, escCastle.h]
2020-05-14 Fix incorrect Rx/Int pin
2020-05-15 Change esc default prototol to none
2020-05-18 Add test xml
    [test_v4.ods]
2020-05-20 Improve voltage and current transformations HWV4V5
2020-05-24 Avoid hang if rx not connected
    [escCastle.cpp]
2020-05-24 Reduce failsafe cycles trigger
    [escCastle.h]
2020-07-17 Add analog airspeed sensor
2020-07-19 Generalize sensor's transfer formula
2020-11-12 Current to 0 wIth PWM
2020-11-12 Current to 0 with THR
2020-11-26 Calibrate current sensor HW V4/V5
2020-12-19 Fix Castle Link bug
    [escCastle.cpp]
2021-01-06 No calibration
2021-01-07 Add Rx protocols XBUS and SRXL
    * Add Rx protocols XBUS and SRXL
    * Update readme
    * Add new Rx protocols
    * Cosmetics
    * Cosmetics
    * Add rx protocols xbus, srxl
    * Add rx protocols xbus and srxl
    * Add rx protocols xbus and srxl
    * Add rx protocols xbus and srxl
    * Add rx protocols xbus and srxl
    * Add rx protocols xbus and srxl
    * Some fixes
    [bn220.cpp, config.h, device.h, escCastle.cpp, escCastle.h, escHW3.h, escHW4.h, escPWM.h]
2021-01-16 Support for ATMega328PB (#15)
    * Add support for ATMega328PB
    * Fix bug
    * Fix bug
    * Fix bug
    * Fix timer2 scaler
    * Fix bug
    * Fix timer2 scaler
    * Prevent matrix out of bounds
    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
    [bmp280.cpp, config.h, escCastle.cpp, escCastle.h, escPWM.h, formatData.cpp, msrc.cpp, xbus.cpp]
2021-01-16 Support for ATMega2560 (#16)
    * Add support for ATMega2560
    * Add support for ATMega2560
    * Add support for ATMega2560
    * Add support for ATMega2560
    * Add support for ATMega2560
    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
    [config.h, escCastle.cpp, escCastle.h, escPWM.h, msrc.cpp, xbus.cpp, xbus.h]
2021-01-19 Add atmega32u4 (#17)
    * Add_atmega32u4
    * Add_atmega32u4
    * Fix
    [config.h, escCastle.cpp, escCastle.h, escPWM.h, msrc.cpp, xbus.cpp, xbus.h]
2021-01-23 Fix castle esc
2021-01-24 Improve debug esc
2021-01-24 Change pin for atmega2560 and atmega32u4
2021-01-25 Pin input pullup
2021-01-26 Add Teensy LC & 3.X (#21)
    * Add support for teensy lc
    * Add support for teensy lc
    * Smartport to hardwareSerial
    * Add support for teensy lc
    * Add teensy 3.x
    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
    [config.h, escCastle.cpp, escCastle.h, escPWM.h, msrc.cpp, xbus.cpp]
2021-01-26 Improve pwm rx accuracy
2021-01-28 Prevent ts overflow and assign a null pointer
    [smartport.cpp]
2021-01-28 Add scaler for arm cortex
2021-01-29 Improve PWM input accuracy (#23)
    * Improve pwm in accuracy
    * Fix cortex
    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
    [escPWM.h, msrc.cpp]
2021-01-29 Improve device and sensor classes (#24)
    * Improve devices
    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
    [bmp280.cpp, bmp280.h, bn220.cpp, bn220.h, device.h, escCastle.cpp, escCastle.h, escHW3.h]
2021-01-30 Add arduino nano
2021-01-30 Use timer1 only
2021-01-30 Add boards
2021-01-31 Add support for Kontronik ESCs (#25)
    * Add support for Kontronik esc
    * Reduce debug strings
    * Add support for Kontronik esc
    * Optimize code for size
    * Add esc kontronik
    * Add debug modes
    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
2021-01-31 Add cellcount filter
2021-02-05 Refactor (#26)
    * Refactoring
    * Refactoring
    * Refactoring
    * Refactoring
    * Refactor
    * Refactor
    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
    [config.h, escCastle.cpp, escCastle.h, escPWM.h, msrc.cpp, smartport.cpp, smartport.h, xbus.h]
2021-02-18 Add I2C to config.h
2021-02-19 Avoid garbage values if BMP280 is not connected
    [bmp280.cpp, bmp280.h]
2021-02-28 Fix I2C data
2021-02-28 Fix receive config bug
    [smartport.cpp]
2021-03-07 Fix delete devices
2021-03-08 Reduce PWM max cycle
2021-03-08 Adjust max PWM duration
2021-03-08 Improve PWM measurement
2021-03-11 Update hw esc signature list
2021-03-11 Update I2C scanner
2021-03-11 Update I2C scan
2021-03-13 Fix sensorDouble formatted
2021-03-17 Remove PWM out description
2021-03-17 Add BMP280 voltage remark
2021-03-18 Add ESC signature and raw current to telemetry
2021-03-21 Filter for ibus sensor commands only
2021-03-23 Fix analog current sensor formula
2021-03-23 Fix analog current formula
2021-03-27 Filter frames with values out of range
2021-03-27 Always update sensor
2021-03-27 Remove current from filter
2021-03-27 Remove temp from filter
2021-03-27 Add analog sensors to filter
2021-03-27 Fix filter
2021-03-28 Current auto offset
2021-09-01 Improve current calculation
2021-09-01 Add init delay for FlyFun ESC
2021-09-02 Esc Rx pin low on delay
2021-09-03 Fix Castle ESC for Teensy LC/3.x
    [escCastle.cpp, msrc.cpp]
2021-09-03 Fix Frsky sBec multiplier
    [formatData.cpp]
2021-09-05 Fix bug esc delay
    [msrc.cpp]
2021-09-05 Fix bug current auto offset
    [msrc.cpp]
2021-09-05 Calculate current consumption
2021-09-09 Add support for i2c_t3 library
2021-09-09 Enable i2c range on teensy lc/3.x
2021-09-12 Support for Sbus2 (#47)
    * Add sbus support
    * Add sbus support
    * Add sbus support
    * Add sbus support
    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
    [config.h, formatData.cpp, msrc.cpp, sbus.cpp, sbus.h, sensor.cpp, sensor.h]
2021-09-13 Avoid partial gps flag bites set
    [xbus.cpp]
2021-09-14 Fix airspeed bug xbus
    [xbus.cpp]
2021-09-14 Fix xbus gps flags
    [xbus.cpp]
2021-09-14 Add pwmout to xbus
2021-09-14 Limit sensors to 16 max
2021-09-18 Fix xbus gps sats
    [xbus.cpp]
2021-09-20 Add partial support for Teensy 4.x
2021-09-21 Add xbus support for Teensy 4.x
2021-09-22 Add teensy half duplex
2021-09-22 Add teensy cortex half duplex
2021-09-22 Add arm cortex half duplex
2021-09-25 Remove Rx pin from Frsky D
2021-09-26 Revert smartport serial timing
    [smartport.cpp]
2021-10-12 Add hardware and software serial drivers (#50)
2021-10-12 Fine tune (#51)
    * Add hardware and software serial drivers
    * Fine tune
    * Fine tune
2021-10-15 Disable rx interrupt while transmitting
2021-10-16 Improve avr hardware serial driver for half duplex
2021-10-17 Fix software serial for half duplex
    [softserial.cpp, softserial.h]
2021-10-17 Fix half duplex softserial
    [softserial.cpp]
2021-10-17 Update half duplex resistance value
2021-10-17 Remove pull down resistor
2021-10-19 Fix teensylc/3.x uart
2021-10-25 Jeti Ex Bus (#52)
    * Add Jeti Ex Bus
    * Half duplex
    * Fix bad crc count
    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
    [constants.h, jetiex.cpp, jetiex.h, msrc.cpp, sensor.cpp, sensor.h]
2021-10-25 Fix negative values multiplex
    [formatData.cpp, multiplex.cpp]
2021-10-26 Fix msrc_gui bug airspeed
    [mainwindow.cpp]
2021-10-27 Fix time format xbus
    [xbus.cpp, xbus.h]
2021-10-27 Fix bn220 init bug
    [bn220.h]
2021-10-28 Fix esc serial bug
    [xbus.cpp]
2021-10-28 Fix jeti ex coordinates format
    [jetiex.cpp]
2021-10-30 Remove i2c_t3 from teensy 3.0
2021-12-11 Fix hard and soft serial for atmega32u4
    [softserial.cpp, softserial.h]
2021-12-11 Fix teensy current and pressure pins
    [constants.h]
2021-12-12 Fix HW4 no data when motor off
2021-12-13 Fix xbus i2c
2021-12-13 Fix sim rx smartport
    [smartport.cpp]
2021-12-13 Fix i2c xbus
2021-12-14 Add multipliers for voltage and current analog sensors
2021-12-21 Fix millis overflow for ARM Cortex
    [frsky_d.cpp, ibus.cpp, jetiex.cpp, multiplex.cpp, sbus.cpp, smartport.cpp]
2022-01-02 Add HW V4/V5 current threshold
2022-01-02 Fix ESC_INIT_DELAY for ATmega328PB
    [msrc.cpp]
2022-01-03 Add threshold current filter
2022-01-03 Add threshold filter
2022-01-04 Add battery consumption
2022-01-16 Only one ESC driver for boards with 28kb flash
2022-01-17 Add case 2 to Jeti Ex bus
2022-01-17 Change ESC serial port based on Rx protocol
2022-01-19 Fix ADC resolution for ARM Cortex
    [voltage.cpp, voltage.h]
2022-01-19 Revert 12 bits ADC for ARM Cortex
    [voltage.h]
2022-01-26 Update HW V4 voltage and current parametes
2022-02-01 Avoid write Jeti too late
    [hardserial.h, jetiex.cpp]
2022-02-01 Add cortex to jeti bus filter
2022-02-04 Do not use software serial for sensors
2022-02-05 Avoid long intervals to calculate consumption
    [functions.cpp]
2022-02-06 Fix soft serial for atmega32u
    [softserial.cpp]
2022-02-07 Add Ibus disabled sensors
2022-02-07 Add multiplex disabled sensors
2022-02-07 Fix Ibus AC packet definition
    [ibus.cpp, sensor.cpp, sensor.h]
2022-02-08 Fix Ibus type S32
    [ibus.cpp]
2022-02-08 Add second voltage/ntc xbus
2022-02-08 Revert consumption filters
2022-02-09 Some fixes Jeti Ex Bus
    [jetiex.cpp, jetiex.h, softserial.cpp, softserial.h]
2022-02-10 Fix Ibus speed multiplier
    [formatData.cpp]
2022-02-10 Refactor Ibus sensor
2022-02-10 Reintroduce consumption filter
2022-02-10 Consumption calculation filter improvement
2022-02-10 Add BMP temperature
2022-02-11 Fix Ibus bmp280 altitude
    [ibus.cpp]
2022-02-11 Fix Ibus temperature and sats format
    [formatData.cpp]
2022-02-12 Add current consumption
2022-02-12 Fix sim sensors
2022-02-13 Jeti Ex change sensors cycling
2022-02-13 Fix HW V4 filter
2022-02-16 Fix sbus timing and serial format
    [mainwindow.cpp, sbus.cpp, sbus.h]
2022-02-16 Adjust sbus slot timing
2022-02-18 Mask Ibus sensor 0x01 to increase init time
2022-02-19 Fix softserial for atmega32u4
    [softserial.cpp]
2022-02-19 Fix sbus for atmega32u4
    [sbus.cpp]
2022-02-19 Add alternative Ibus lat lon sensor
2022-02-19 Fix Ibus alternative gps sensors format
    [formatData.cpp]
2022-02-20 Fix sbus slot format
    [formatData.cpp, sbus.cpp]
2022-02-20 Increase lower pwm rpm detection
2022-02-20 Fix cortex pwm rpm
    [escPWM.h]
2022-02-20 Fix diode orientation
2022-02-20 Revert diode orientation
2022-02-21 Hitec (#67)
    * Add Hitec support
    * Fix Hitec current and temp
    * Fix gps sats
    * Update config
    * Fix telemetry format
    * Adjust voltage sensor
    * Add Hitec support
    * Fix Hitec current and temp
    * Fix gps sats
    * Update config
    * Fix telemetry format
    * Adjust voltage sensor
    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
    [bn220.cpp, config.h, constants.h, current.cpp, hitec.cpp, hitec.h, mainwindow.cpp, msrc.cpp]
2022-02-21 Sbus (#68)
    * Another sbus attempt
    * Fix diode orientation
    * Sbus to default slots
    * Another sbus attempt
    * Sbus to default slots
    [config.h, sbus.cpp, sbus.h]
2022-02-21 Futaba slots to defaults
2022-02-27 Add donate button
2022-03-01 Fix Sbus (#70)
    * Config
    * Config
    * Update
    * Update
    * Update
    * Adjust timing
    * Update
    * Update
    * Config
    * Config
    * Fix air speed formatting
    * Check voltage sensor
    * Check voltage sensor
    * Check voltage sensor
    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
    [bmp280.cpp, bn220.cpp, config.h, formatData.cpp, pressure.cpp, sbus.cpp, sbus.h, xbus.cpp]
2022-03-03 Remove diode
2022-03-04 Fix wrong atmega328pb definition in arduino ide
    [escPWM.h, hardserial.h, msrc.cpp, sbus.cpp, sbus.h, softserial.cpp, softserial.h, xbus.cpp]
2022-03-06 Fix castle for atmega32u4
    [escCastle.cpp]
2022-03-06 Fix pwm
2022-03-06 Fix castle for cortex
    [escCastle.cpp]
2022-03-07 Avoid capture at 0
    [escCastle.cpp]
2022-03-07 Disable gps some sensors
2022-03-07 Fix pwm max cycles
2022-03-08 Restore gps sensors
2022-03-08 Ibus (#73)
    * Remove sensor mask for first sensor
    * Add dummy sensor 1 for Ibus
    * DTH to 0 at init
    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
2022-03-10 Fix BMP280 alpha def
    [frsky_d.cpp, hitec.cpp, ibus.cpp, jetiex.cpp, multiplex.cpp, smartport.cpp]
2022-03-11 MS5611 (#74)
    * Add MS5611
    * Add MS5611
    * Add MS5611
    * Add MS5611
    modificados: msrc/frsky_d.h
    modificados: msrc/hitec.h
    modificados: msrc/ibus.h
    modificados: msrc/jetiex.h
    modificados: msrc/msrc.h
    modificados: msrc/multiplex.h
    modificados: msrc/sbus.h
    modificados: msrc/smartport.h
    modificados: msrc/srxl.h
    modificados: msrc/xbus.h
    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
    [bmp280.h, config.h, constants.h, frsky_d.cpp, frsky_d.h, functions.cpp, functions.h, hitec.cpp]
2022-03-12 Fix speed kmh transformation
    [bn220.cpp]
2022-03-13 Fix I2C field
2022-03-19 Fix Jeti decimals for negative values
    [jetiex.cpp]
2022-03-20 Add power source and M-Link
2022-03-20 Add power source
2022-03-20 Update power source connections
2022-03-24 Add dinamic circuit
2022-03-24 Fix circuit
2022-03-25 Update circuits
2022-03-25 Update Castle circuits
2022-03-27 Add open loop hall effect offset
2022-03-27 Improve current multiplier
2022-03-27 Add current offset
2022-03-27 Add current sensor type
2022-03-28 Update current multiplier
2022-03-28 Analog current sensor offset
2022-03-28 Fix current consumption
2022-03-29 Add pwm out to msrc_gui
2022-04-01 Change pin softserial atmega328pb
2022-04-01 Workaround chip timer bug atmega328pb
    [escCastle.cpp]
2022-04-01 Change softerial pin atmega328pb
2022-04-03 Fix smartport size flash
    [smartport.cpp, smartport.h]
2022-04-03 Fix compilation for teensy2
    [formatData.cpp, softserial.h]
2022-04-03 Fix arduino micro flash size
    [smartport.cpp, smartport.h]
2022-04-04 Add led blinking
2022-11-29 Fix Castle schematic image
